Bit101-git/passive_drone_detection-PDD/Images/2.4_GHz_RF_Activity.png

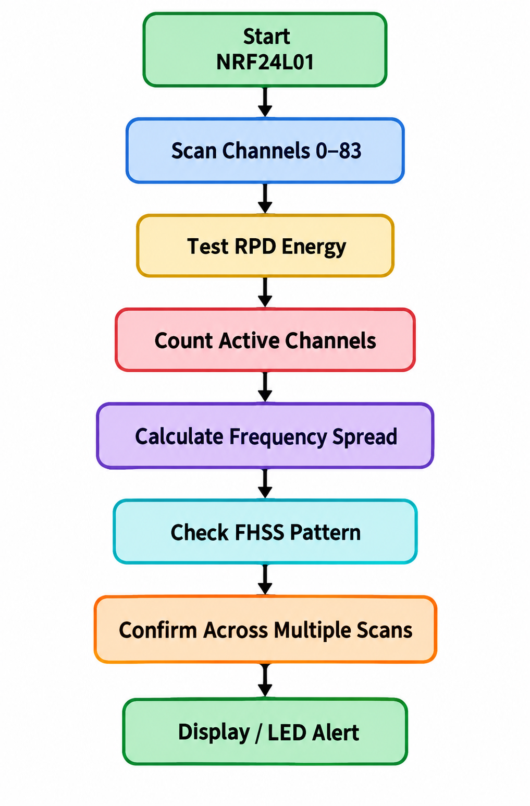
Images/2.4_GHz_RF_Activity.png
