Bit101-git/passive_drone_detection-PDD/Images/Analog_FPV_Video.png

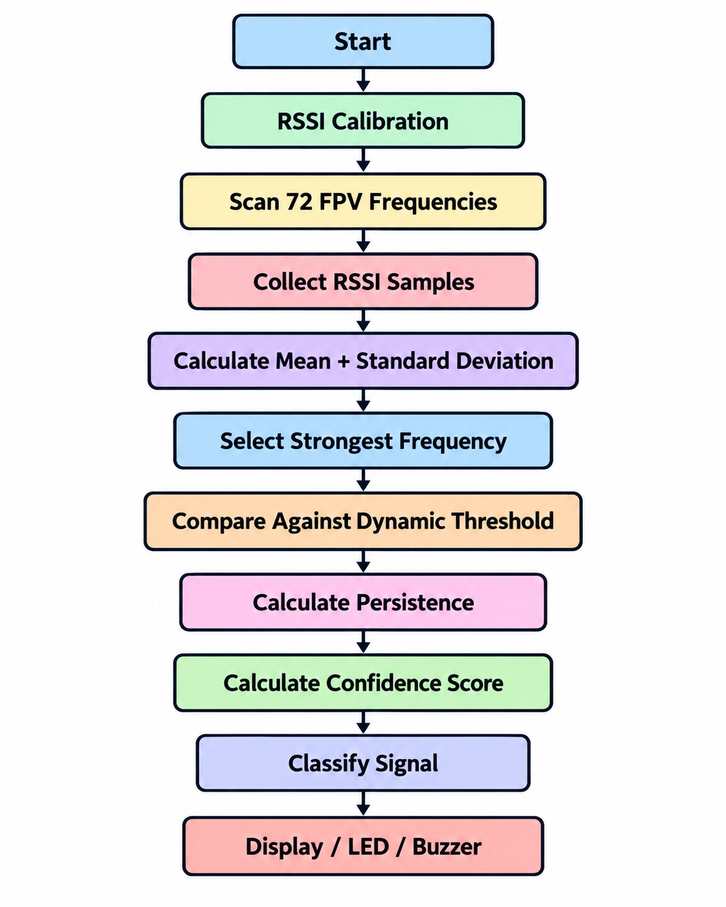
Images/Analog_FPV_Video.png
