Bit101-git/passive_drone_detection-PDD/Images/How Detection Works.png

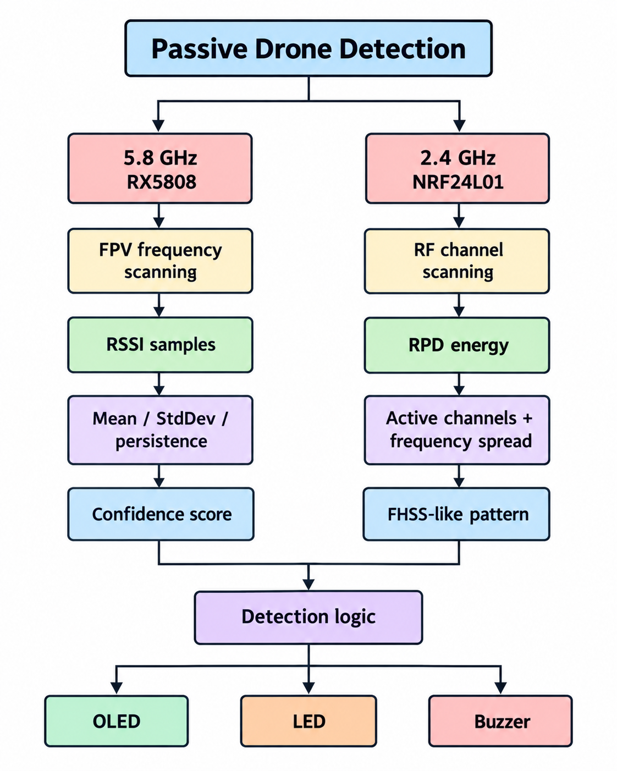
Images/How Detection Works.png
